badgeteam/hdmi2mipi/hdmi2mipi.kicad_pcb

## KiCad design hdmi2mipi.kicad_pcb (2024-03-29)

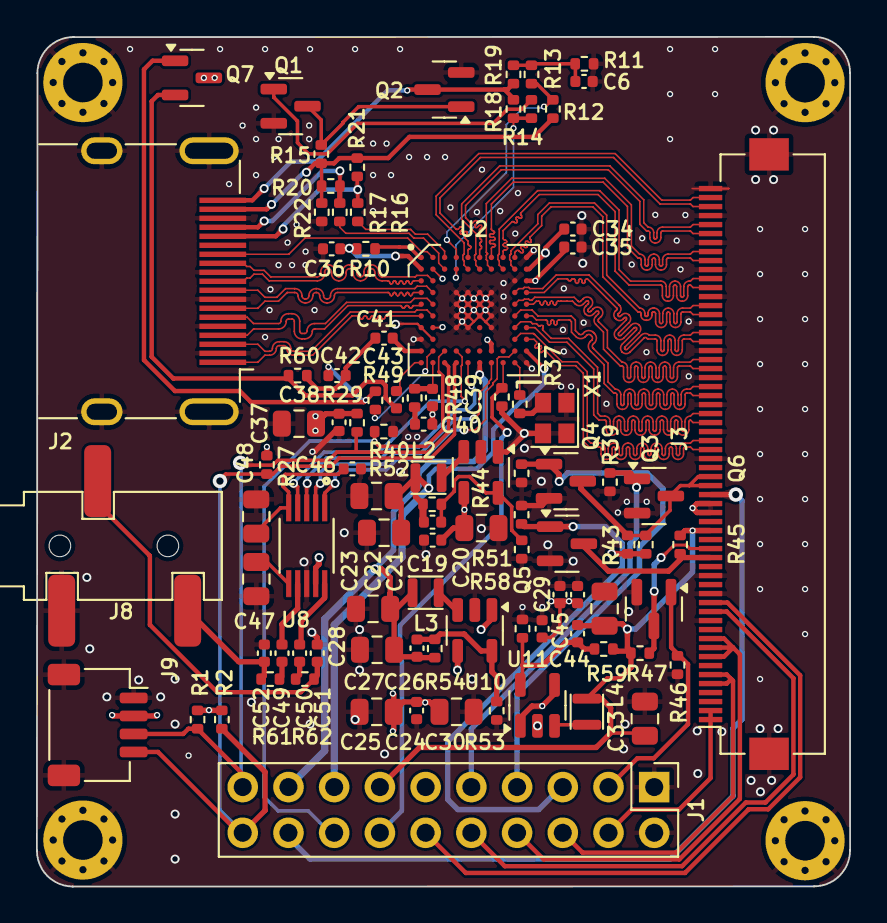
[picture p1: board hdmi2mipi.kicad_pcb from above]

Board: 4 copper layers, 45.2 x 47.2 mm, 99 parts (0 on the bottom side), 91 nets.

Parts:
C6, C40, C41: 0.1u; C_0402_1005Metric
C19, C24, C29, C34, C35, C36, C38, C45, C46, C49, C50: 100n; C_0402_1005Metric
C20, C22, C23, C25, C27, C28, C30, C32, C33, C37: 22u; C_0805_2012Metric
C21, C26, C31: 22p; C_0402_1005Metric
C39, C43: 1n; C_0402_1005Metric
C42: 5p; C_0402_1005Metric
C44: 1u; C_0402_1005Metric
C47, C48: 47u; C_0805_2012Metric
C51, C52: 39n; C_0402_1005Metric
H1, H2, H3, H4: MountingHole_Pad; MountingHole_2.2mm_M2_Pad_Via
J1: IO; PinHeader_2x10_P2.54mm_Vertical
J2: HDMI_A_1.4; HDMI_A_Molex_208658-1001_Horizontal
J3: Hirose_FH52-60S-0.5SH_1x60-1MP_P0.50mm_Horizontal
J8: AudioJack3; Boom-audiojack-PJ-320B
J9: QWIIC; JST_SH_SM04B-SRSS-TB_1x04-1MP_P1.00mm_Horizontal
L2, L3, L4: 2.2u; Inductor_MSC20FC
Q1, Q2, Q3, Q4, Q5, Q6: BC846; SOT-23
Q7: 2SC2712; SOT-23
R1, R2, R10: 2k; R_0402_1005Metric
R11: 48k; R_0402_1005Metric
R12: 0; R_0402_1005Metric
R13, R49: 1.5k; R_0402_1005Metric
R14, R20, R21, R27, R29, R41, R43, R45, R47: 4.7k; R_0402_1005Metric
R15, R38, R39, R40, R42, R44, R46, R51, R52, R53, R58: 10k; R_0402_1005Metric
R16, R17, R37: 33; R_0402_1005Metric
R18, R19, R48, R60: 1k; R_0402_1005Metric
R22: 100k; R_0402_1005Metric
R54: 8.2k; R_0402_1005Metric
R59: 20k; R_0402_1005Metric
R61, R62: 330; R_0402_1005Metric
U2: tc358840xbg
U8: MS4344; SOP50P490X110-10N
U9, U10, U11: SY8079AAC; SOT-23-5
X1: SG-210STF; Oscillator_SMD_SeikoEpson_SG210-4Pin_2.5x2.0mm

Connections:
1V8_S1: J1.3, Q6.1 (B), R46.1
1V8_S2: J1.5, Q5.1 (B), R44.1
3V3_HDMI: C19.1, C20.1, C24.1, C25.1, C29.1, C30.1, C36.1, C37.1, C38.1, C44.1, C45.1, J1.11, J3.24 (3.3v), J3.25 (3.3v), J9.2, Q7.3 (C), R1.1, R2.1, R10.2, R27.1, R29.1, R38.1, R41.1, R43.1, U2.B1 (VDD33_HDMI), U2.G1 (VDD33_HDMI), U2.H2 (VDDIO33), U2.J7 (VDDIO18), U8.9 (VA), U9.1 (EN), U9.4 (VIN), U10.1 (EN), U10.4 (VIN), U11.1 (EN), U11.4 (VIN), X1.1 (~ST), X1.4 (Vcc)
3V3_S1: J1.7, Q4.1 (B), R42.1
3V3_S2: J1.9, Q3.1 (B), R39.1
+1V1: C26.1, C27.1, C28.1, C35.1, J1.17, L3.1, R54.1, U2.B2 (VDD11_HDMI), U2.C10 (VDDC11), U2.G2 (VDD11_HDMI), U2.K6 (VDDC11)
+1V2: C21.1, C22.1, C23.1, C34.1, J1.15, L2.1, R52.1, U2.B10 (VDD12_MIPI1), U2.J10 (VDD12_MIPI0)
+1V8: C31.1, C32.1, C33.1, J1.13, J3.22 (1.8v), L4.1, R45.1, R47.1, R59.1
/AUDIO_L: C52.2, J8.T, R61.2
/AUDIO_R: C51.2, J8.R, R62.2
/DSI0_C_N: J3.38 (DSI0CN), U2.F9 (CDSI0CN)
/DSI0_C_P: J3.37 (DSI0CP), U2.F10 (CDSI0CP)
/DSI0_D0_N: J3.32 (DSI0D0N), U2.H9 (CDSI0D0N)
/DSI0_D0_P: J3.31 (DSI0D0P), U2.H10 (CDSI0D0P)
/DSI0_D1_N: J3.35 (DSI0D1N), U2.G9 (CDSI0D1N)
/DSI0_D1_P: J3.34 (DSI0D1P), U2.G10 (CDSI0D1P)
/DSI0_D2_N: J3.41 (DSI0D2N), U2.E9 (CDSI0D2N)
/DSI0_D2_P: J3.40 (DSI0D2P), U2.E10 (CDSI0D2P)
/DSI0_D3_N: J3.44 (DSI0D3N), U2.D9 (CDSI0D3N)
/DSI0_D3_P: J3.43 (DSI0D3P), U2.D10 (CDSI0D3P)
/DSI1_C_N: J3.53 (DSI1CN), U2.B7 (CDSI1CN)
/DSI1_C_P: J3.52 (DSI1CP), U2.A7 (CDSI1CP)
/DSI1_D0_N: J3.47 (DSI1D0N), U2.B9 (CDSI1D0N)
/DSI1_D0_P: J3.46 (DSI1D0P), U2.A9 (CDSI1D0P)
/DSI1_D1_N: J3.50 (DSID1N), U2.B8 (CDSI1D1N)
/DSI1_D1_P: J3.49 (DSID1P), U2.A8 (CDSI1D1P)
/DSI1_D2_N: J3.56 (DSI1D2N), U2.B6 (CDSI1D2N)
/DSI1_D2_P: J3.55 (DSI1D2P), U2.A6 (CDSI1D2P)
/DSI1_D3_N: J3.59 (DSI1D3N), U2.B5 (CDSI1D3N)
/DSI1_D3_P: J3.58 (DSI1D3P), U2.A5 (CDSI1D3P)
/FB11: C26.2, R53.1, R54.2, U10.5 (FB)
/FB12: C21.2, R51.1, R52.2, U9.5 (FB)
/FB18: C31.2, R58.1, R59.2, U11.5 (FB)
/HDMI_0_N: J2.9 (D0-), U2.D2 (HDMID0N)
/HDMI_0_P: J2.7 (D0+), U2.D1 (HDMID0P)
/HDMI_1_N: J2.6 (D1-), U2.E2 (HDMID1N)
/HDMI_1_P: J2.4 (D1+), U2.E1 (HDMID1P)
/HDMI_2_N: J2.3 (D2-), U2.F2 (HDMID2N)
/HDMI_2_P: J2.1 (D2+), U2.F1 (HDMID2P)
/HDMI_C_N: J2.12 (CK-), U2.C2 (HDMICN)
/HDMI_C_P: J2.10 (CK+), U2.C1 (HDMICP)
/SW11: L3.2, U10.3 (SW)
/SW12: L2.2, U9.3 (SW)
/SW18: L4.2, U11.3 (SW)
GND: C6.2, C19.2, C20.2, C22.2, C23.2, C24.2, C25.2, C27.2, C28.2, C29.2, C30.2, C32.2, C33.2, C34.2, C35.2, C36.2, C37.2, C38.2, C39.2, C40.2, C44.2, C45.2, C46.2, C47.2, C48.2, C51.1, C52.1, H1.1, H2.1, H3.1, H4.1, J1.1, J1.2, J2.2 (D2S), J2.5 (D1S), J2.8 (D0S), J2.11 (CKS), J2.17 (GND), J2.SH, J3.12 (GND), J3.15 (GND), J3.17 (GND), J3.30 (GND), J3.33 (GND), J3.36 (GND), J3.39 (GND), J3.42 (GND), J3.45 (GND), J3.48 (GND), J3.51 (GND), J3.54 (GND), J3.57 (GND), J3.60 (GND), J3.MP, J8.S, J9.1, J9.MP (MountPin), Q1.2 (E), Q2.2 (E), Q3.2 (E), Q4.2 (E), Q5.2 (E), Q6.2 (E), R11.1, R22.1, R39.2, R40.2, R42.2, R44.2, R46.2, R51.2, R53.2, R58.2, U2.A10 (VSS), U2.C9 (VSS), U2.D4 (VSS), U2.D5 (VSS), U2.D6 (VSS), U2.D7 (VSS), U2.E4 (VSS), U2.E5 (VSS), U2.E6 (VSS), U2.E7 (VSS), U2.F4 (VSS), U2.F5 (VSS), U2.F6 (VSS), U2.F7 (VSS), U2.G4 (VSS), U2.G5 (TEST), U2.G7 (VSS), U2.H1 (VSS), U2.K10 (VSS), U8.8 (GND), U9.2 (GND), U10.2 (GND), U11.2 (GND), X1.2 (GND)
INT: J1.16, R40.1, U2.J3 (INT)
unnamed: C6.1, R11.2, R13.2, R19.2
unnamed: C40.1, R48.2
unnamed: C41.1, C42.2, R60.1
unnamed: C49.1, R61.1
unnamed: C50.2, R62.1
unnamed: J1.4, J3.1 (FB1), J3.2 (FB1)
unnamed: J1.6, J3.5 (FB2), J3.6 (FB2)
unnamed: J1.8, J3.8 (LED+), J3.9 (LED+), J3.10 (LED+)
unnamed: J1.10, J3.13 (5.8v-VEE)
unnamed: J1.12, J3.14 (5.8v-VDD)
unnamed: J2.18 (+5V), R12.1, R15.1, R20.1, R21.1, R22.2
unnamed: J2.13 (CEC), U2.A2 (CEC)
unnamed: J2.19 (HPD/HEAC-), Q2.3 (C), R18.2, R19.1
unnamed: J2.15 (SCL), R16.2, R21.2
unnamed: J2.16 (SDA), R17.1, R20.2
unnamed: J3.20 (1.8-S1), Q6.3 (C), R47.2
unnamed: J3.19 (1.8-S2), Q5.3 (C), R45.2
unnamed: J3.27 (3.3-S2), J3.28 (3.3-S1), Q3.3 (C), Q4.3 (C), R41.2, R43.2
unnamed: Q1.1 (B), R14.1
unnamed: Q1.3 (C), Q2.1 (B), R15.2
unnamed: C42.1, Q7.1 (B), R49.1
unnamed: C43.1, Q7.2 (E), R60.2
unnamed: U2.J4 (A_OSCK), U8.4 (MCLK)
unnamed: U2.K7 (A_SCK), U8.2 (~DEM/SCLK)
unnamed: U2.J9 (A_SD0), U8.1 (SDIN)
unnamed: U2.K5 (A_WFS), U8.3 (LRCK)
unnamed: C41.2, U2.J1 (BIASDA)
unnamed: R49.2, U2.J2 (DAOUT)
unnamed: R16.1, U2.A3 (DDC_SCL)
unnamed: R17.2, U2.B3 (DDC_SDA)
unnamed: R12.2, R13.1, U2.A4 (HPDI)
unnamed: R14.2, R18.1, U2.B4 (HPDO)
unnamed: C43.2, U2.K1 (PCKIN)
unnamed: C39.1, R48.1, U2.K2 (PFIL)
unnamed: R37.2, U2.K9 (REFCLK)
unnamed: R10.1, U2.A1 (REXT)
unnamed: C49.2, U8.7 (AOUTL)
unnamed: C50.1, U8.10 (AOUTR)
unnamed: C47.1, U8.6 (FILT+)
unnamed: C46.1, C48.1, U8.5 (VQ)
unnamed: R37.1, X1.3 (OUT)
RESET: J1.14, R38.2, U2.K8 (~RESET)
SCL: J1.20, J9.4, R2.2, R27.2, U2.K4 (I2C_SCL)
SDA: J1.19, J9.3, R1.2, R29.2, U2.K3 (I2C_SDA)
VIN: J1.18, J3.26 (5v)
