badgeteam/hdmi2mipi/(commit log)

2024-02-22 Simplify and get ready for component placement and routing
    [hdmi2mipi.kicad_pcb, hdmi2mipi.kicad_sch]
2024-02-27 tracing done
    [hdmi2mipi.kicad_pcb]
2024-02-28 labels ordering
    [hdmi2mipi.kicad_pcb]
2024-02-29 changed layout
    [hdmi2mipi.kicad_pcb]
2024-03-02 made smaller board
    [hdmi2mipi.kicad_pcb]
2024-03-03 Small fixes and combine 2.54mm headers
    [hdmi2mipi.kicad_pcb, hdmi2mipi.kicad_sch]
2024-03-05 Fixed some routing issues and a bunch of DRC rule violations. Set the board setup to JLCPCB constraints.
    [hdmi2mipi.kicad_pcb]
2024-03-06 Changed copper layers, heaps of other issues.
    [hdmi2mipi.kicad_pcb, hdmi2mipi.kicad_sch]
2024-03-07 Fixed many warnings and errors.
    [hdmi2mipi.kicad_pcb]
2024-03-29 Last tweaks and order at JLC
    [hdmi2mipi-badgeteam-bom.csv, hdmi2mipi.kicad_pcb, hdmi2mipi.kicad_sch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]
