badgeteam/hdmi2mipi/(notices)

Notices in the files:
hdmi2mipi.kicad_pcb:
CERN-OHL-P
